bsfconception/SmartHub/PCB/Master-brd.png

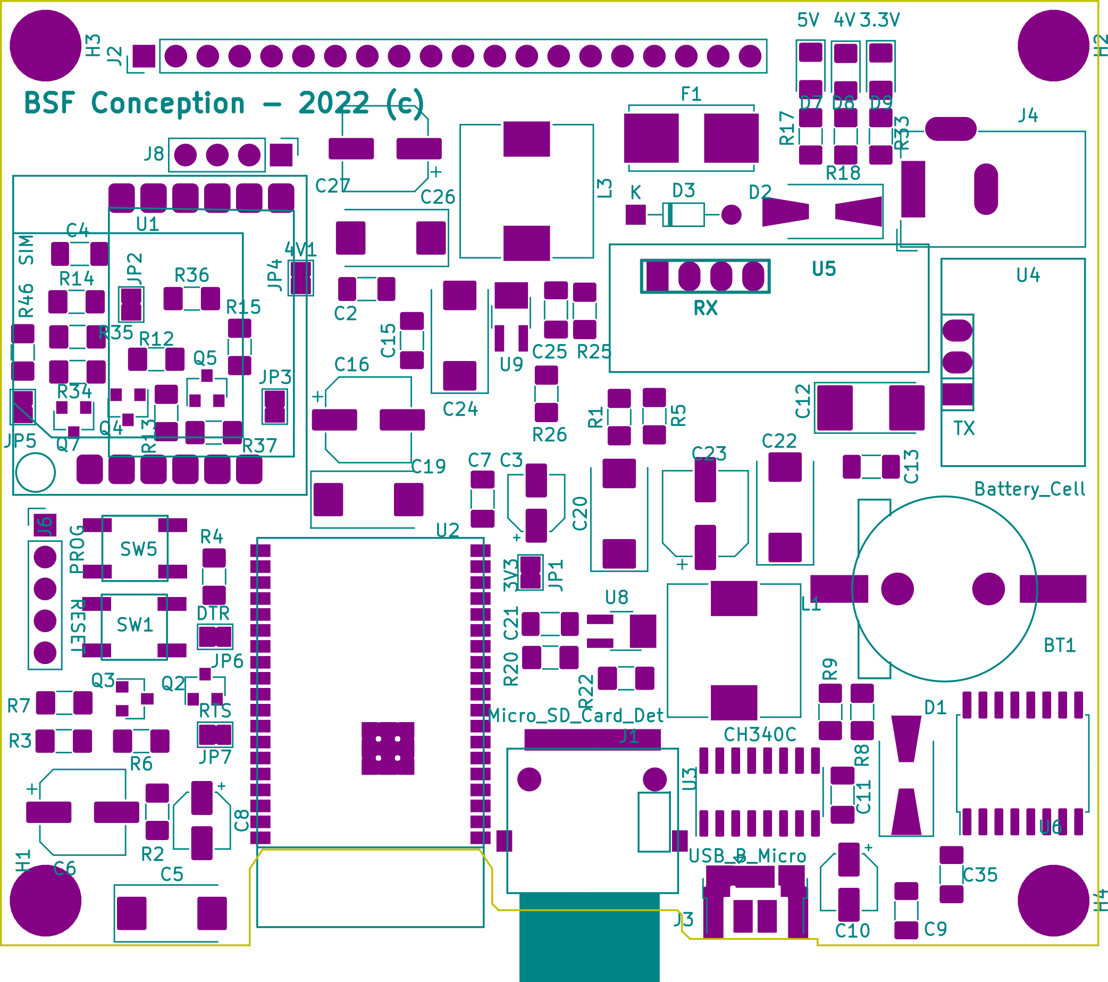
PCB/Master-brd.png
