bsfconception/SmartHub/PCB/Slave-brd.png

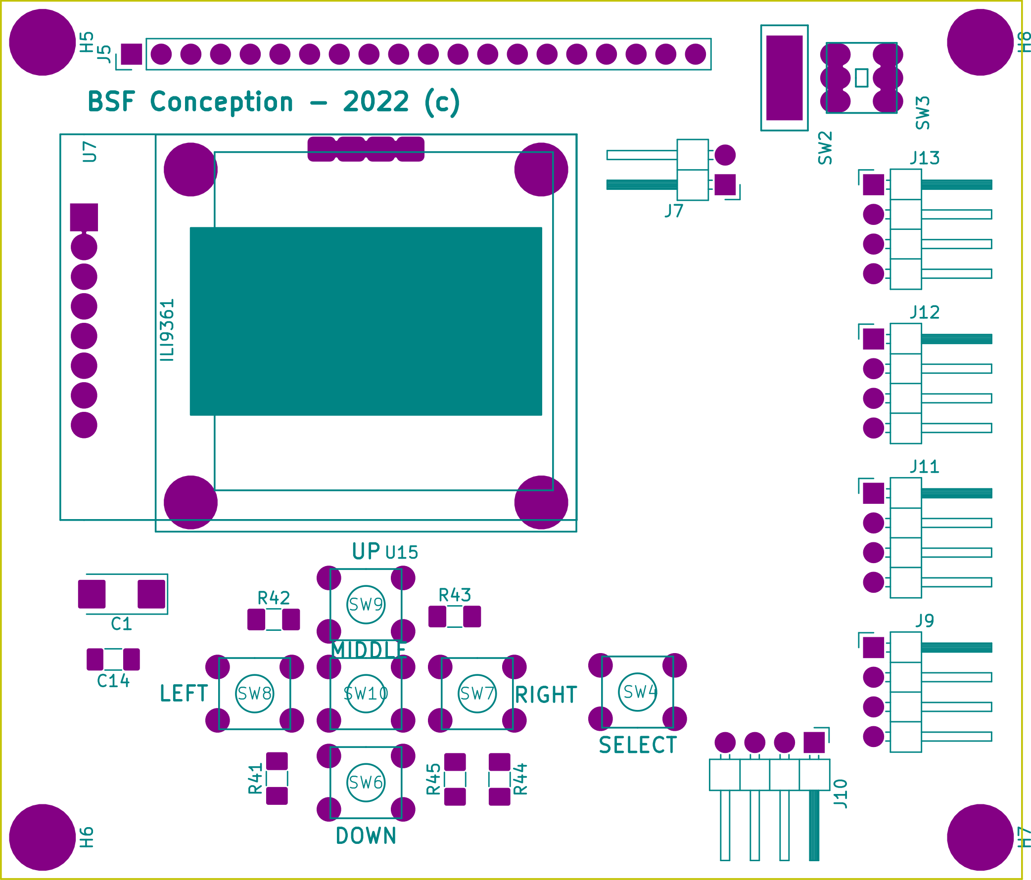
PCB/Slave-brd.png
