bsfconception/SmartHub/Schematic/SmartHub.pdf

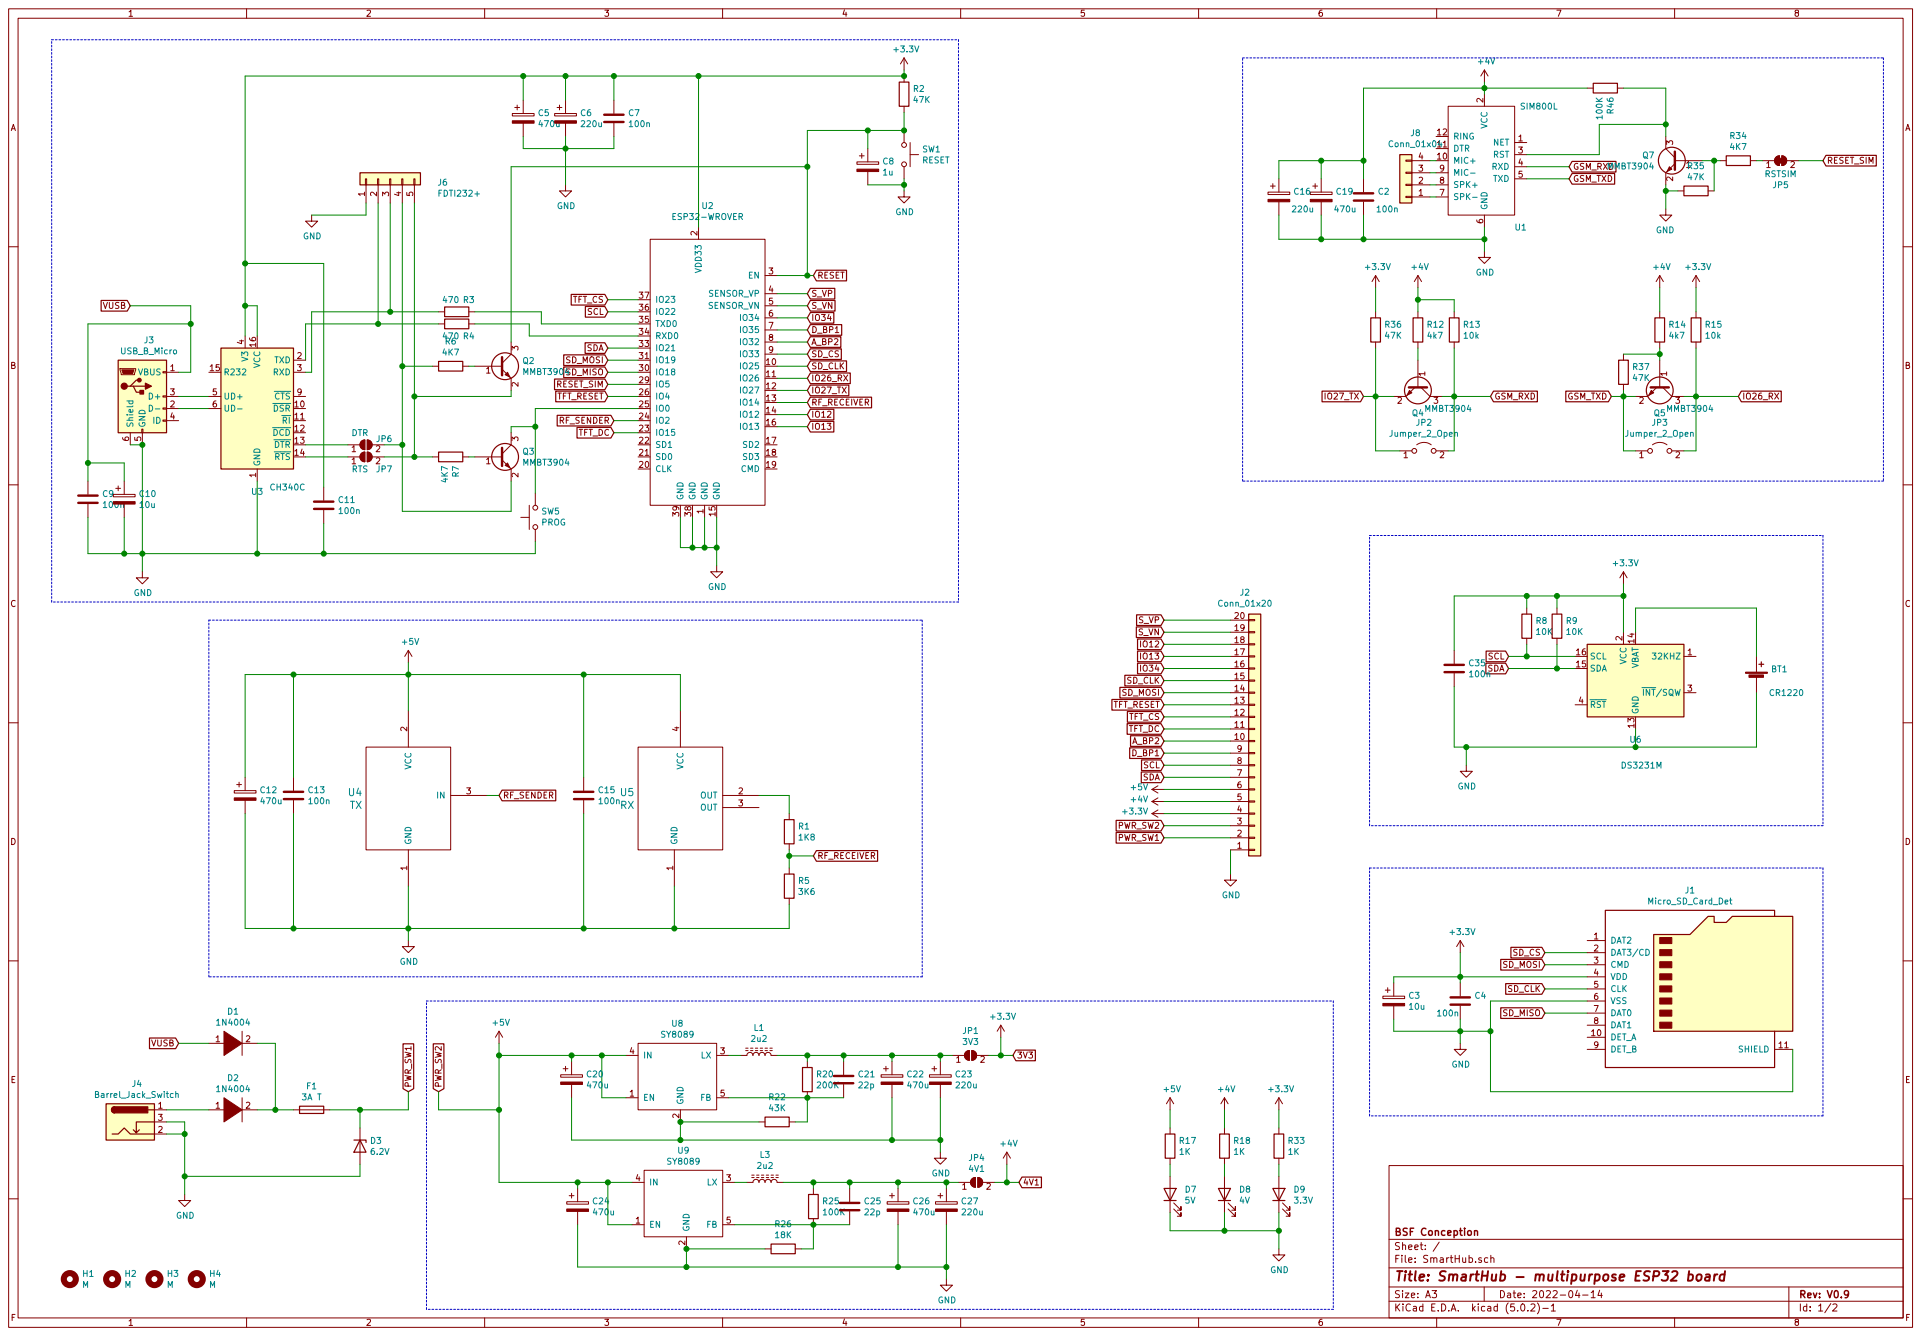
[picture p3: page 1]

2 RST 3 RXD 4 TXD 5 GND

1 DSR 10 RI 11 DCD 12 DTR 13 RTS 14 R232 15 VCC 16 TXD 2 RXD 3 V3

File: SmartHub.sch Sheet: / BSF Conception

Id: 1/2 Title: SmartHub - multipurpose ESP32 board

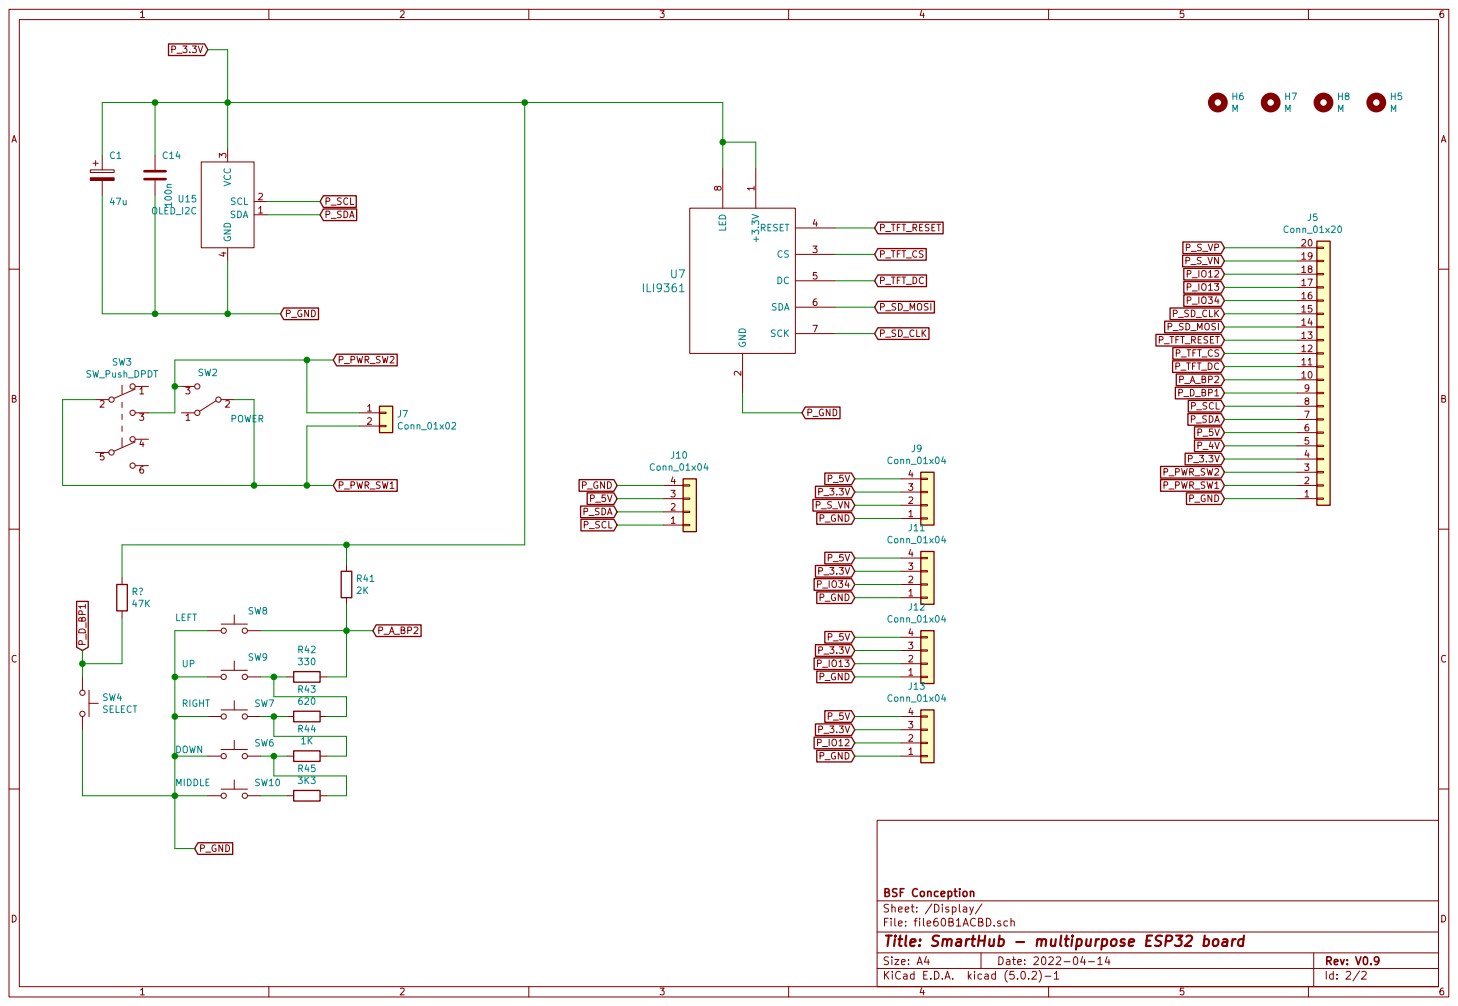
[picture p4: page 2]

BSF Conception
File: file60B1ACBD.sch Sheet: /Display/
Id: 2/2 Title: SmartHub - multipurpose ESP32 board
